ScienceAnimation/SA_nfc_mp3_player_realTag_WDT_IRQ3/schéma élec.png

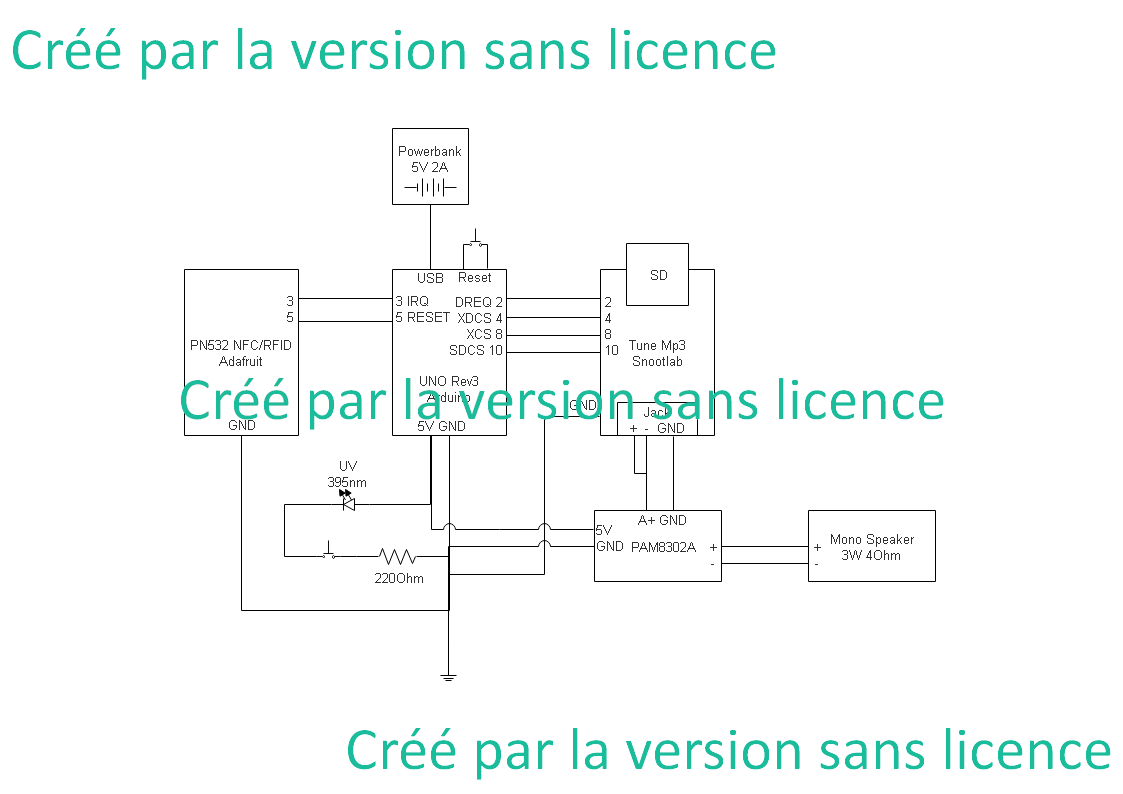
schéma élec.png
